Louis-Legere/PixelFarmingContest/README.md

# PixelFarmingContest
This is the repository for the pixel farming robot contest. <br>
[Motor Setup guide](Docs/markdownFiles/motorSetupGuide.md)
