Louis-Legere/PixelFarmingContest/Robot Competition Docs/Handover/OneDrive_1_9.9.2024/Reports/Plan of action.docx

# Agrobot competition

Plan of Action

Fontys Venlo

06-10-2023

By Boris Bonchev, Tom Jacobs, Nils Kronig, Duarte Somsen, and Liz van Tienoven.

Contents

# Version control

Version | Purpose/Change | Date
0.1 | Initial draft | 06/10/2023

# 1. Requirements

## 1.1 Fixed requirements

- The Agrobot must not exceed the given dimensions [1].
- The Agrobot must not weigh more than 100kg.
- The Agrobot must be able to move over all the planters and collection bins.
- The Agrobot must be able to pick up individual crops.
- The Agrobot must use image recognition software to recognize the type of crop and its location in the pixel.
- Crops shall be sorted into their appropriate bin.
- Harvesting and sorting shall not take longer than 15 minutes.
- The purchasing budget must not exceed €3.000, -.

## 1.2 Variable requirements

- The Agrobot is modular so it can be transported easily.
- The motors for the tires are strong enough to not get stuck in the dirt.
- The Agrobot uses gps with a base station to determine its location on the field.

## 1.3 Wishes

- The Agrobot sorts the crops internally first, before dropping the contents into the bins.
- The amount of money spent should be as low as possible.

Users | Manufactures | Requirements | Fixed | Variable | Wish | Success criteria
| X | The Agrobot must not exceed the given dimensions. | X | | | The Agrobot is smaller than the maximum dimensions.
| X | The Agrobot must not weigh more than 100 kg | X | | | The Agrobot is lighter than 100kg.
| X | The Agrobot must be able to move over all the planters and collection bins. | X | | | The Agrobot has a slot large enough to drive over the planters and collection bins.
| X | The Agrobot must be able to pick up individual crops. | X | | | The Agrobot has a gripper and vision to select and grip a single crop.
| X | The Agrobot must use image recognition software to recognize the type of crop and its location in the pixel. | X | | | The Agrobot has a camera and a vision model trained to detect the location and type of plants.
| X | Crops shall be sorted into their appropriate bin. | X | | | The Agrobot places the harvested crops into the corresponding bin.
| X | Harvesting and sorting shall not take longer than 15 minutes. | X | | | The complete harvesting and sorting are completed within 15 minutes.
| X | The purchasing budget must not exceed €3.000, - | X
| X | The Agrobot is modular so it can be transported easily. | | X | | The robot can be taken apart into large parts to facilitate transportation.
| X | The motors for the tires are strong enough to not get stuck in the dirt. | | X | | The Agrobot does not get stuck in the dirt during operation.
| X | The Agrobot uses gps with a base station to determine its location on the field. | | X | | The Agrobot can navigate through the field based on gps.
| X | The Agrobot sorts the crops internally first, before dropping the contents in the bins. | | | X | The Agrobot collects multiple types of crops which end up in their corresponding bins.
| X | The amount of money spent should be as low as possible | | | X

# 2. Risk analysis

| | | | Probability of Occurrence
| | | | Rarely | Unlikely | Possible | Likely | Certain
| Operational | Effects | Rate | 1 | 2 | 3 | 4 | 5
Possible consequences | Critical impact. Possible project termination | Catastrophic | 5 | 5 | 10 | 15 | 20 | 25
| Major/ significant impact. Severe disruption to the project | Major | 4 | 4 | 8 | 12 | 16 | 20
| Moderate impact. Moderate disruption to the project | Moderate | 3 | 3 | 6 | 9 | 12 | 15
| Localized impact. Disruption to the project. | Minor | 2 | 2 | 4 | 6 | 8 | 10
| Minimal or no impact. Minimal disruption. | Insignificant | 1 | 1 | 2 | 3 | 4 | 5

Legend
RPN | Risk priority number
NP | New probability
NI | New Impact
NRPN | New Risk Priority Number

Cause | Risk | Effect | Probability | Impact | RPN | Measure to be limited | Action holder | NW | NI | NRPN
Parts don’t get delivered on time | | | | | | Don’t order from AliExpress
Scope to big | Lack of Time | Project delayed/ unfinished | 5 | 4 | 20 | Try to limit Scope by taking as many compromises as possible | All team Members | 3 | 3 | 9
Physical/ Mechanical failure later in Project | Lack of Time | Project delayed/ unfinished | 2 | 4 | 8 | Order quality parts from trusted vendors. | All team members | 1 | 4 | 4
Miscommunication within the team | Stagnation of the project | Project delayed | 3 | 4 | 12 | Spend more time on diagrams, documents and other communication. | All team members | 2 | 3 | 6
Not able to work in the workshop | Stagnation of project | Project delayed | 4 | 4 | 16 | Reserve the workshop for some time each week. | All team members | 2 | 4 | 8

# 3. Planning

What? | By whom? | When?
Plan of action | Whole team | Week 40
Set up ROS | Boris, Duarte, Tom | Week 41
Set up ROS simulation environment | Tom | Week 41
Vacation | | Week 42
Gripper design | Liz, Nils | Week 42
Pathfinding in simulation | Tom | Week 44
Gripper translation in simulation | Boris | Week 44
Robot Base design | Liz, Nils | Week 44
AI plant recognition | Duarte | Week 45
Gripper | Liz, Nils | Week 45
Agrobot mechanical part complete | Liz, Nils | Week 46
Gripper software | Boris | Week 47
GPS location | Tom | Week 47
Pathfinding on robot | Tom | Week 49
Crop sorting and delivery | Duarte, Boris (help)
Electrics complete | Liz, Nils | Week 1
Vacation | | Week 52 / 1
Agrobot complete | Whole team | Week 2
Agrobot testing | Whole team | Week 3
COMPETITION!!! | Whole team | Week 4

Week (CW) | 40 | 41 | 42 | 43 | 44 | 45 | 46 | 47 | 48 | 49 | 50 | 51 | 52 | 1 | 2 | 3 | 4
Plan of action | 06. 10.
writing
Mechanical work | | | | | | | | | | | | | | | | | 25. 01.
Robot Base design
Robot Base Build
Robot Base Improvement
Gripper design
Gripper Build
Electrics of the Base
Electrics of the Gripper
Software work | | | | | | | | | 01. 12.
Object detection
Path planning of robot
Software of Robot arm

# Appendix

## Appendix 1: Permitted dimensions

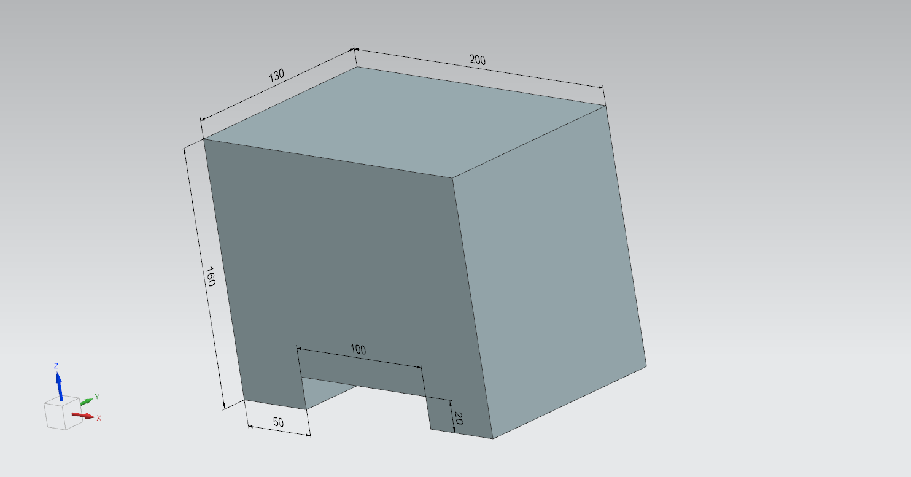
[picture p6: figure]
