Louis-Legere/PixelFarmingContest/Robot Competition Docs/Handover/OneDrive_1_9.9.2024/Reports/Report writings Design and Hardware.docx

Mechanical design

- Constraints for the design
- Previous ideas/designs
- Why this design for the frame?
- Design for the sorting boxes
- Gripper

Hardware

- Why the aluminium profiles?
- Explanation for electronics(?)
- Wheels

While designing the robot, certain constraints had to be taken into consideration.

- The maximum dimensions of the robot are 200x130x160 (WxLxH) cm
- The maximum weight of the robot is 100 kg.
- It has to be able to drive over or around the planter box that is 100x100x20 cm
- It has to be able to harvest the crops that are planted in the planter box.
- The robot has to be able to bring the crops to sorting boxes.

With these constraints in mind, a few designs can be made.

For stability during harvesting, the robot will drive over the planter box. So the robot has to be at least around 120cm wide on the inside, so there is some space left for the wheels and it can easily drive over the planter box. The robot will have internal sorting boxes, so it won’t have to drive to the regular sorting boxes every time it harvests a crop. And it needs an arm that will harvest the crops.

The sorting boxes on the robot had to be designed in such a way that the crops inside could be transferred to the outside sorting boxes fast and easy. Letting the robot arm take each crop and put it in the correct box would take too much time. The solution is to have the bottom of the internal boxes drop open so that the crops just fall into the sorting boxes. The bottom flaps will be connected to the main body of the box with hinges. To get the flaps to open and close again, a stepper motor is used. A disc will be connected to the stepper motor and that disc will roll up a cable that is connected to the flaps. Then by making the stepper motor turn clockwise and anticlockwise, the flaps will open and close.

INSERT PICTURE OF CAD MODELS OF FLAP AND FOLDED BOX

For the gripper, multiple options were considered. Suction using a vacuum cup, gripping the leaves/root from the top and pulling, gripping the leaves/root from the side and pulling. Because of the leaves, vacuum suction is not the best idea because it can never close off completely. Gripping the leaves from the top would be difficult, because they can be very widespread, or the gripper is only able to grab a few leaves and then it will pull with too much force and the leaves rip. Grabbing the root from the top might damage the vegetable and if there are a lot of leaves on top of the root, grabbing the root is not even possible. So the best option is to grab the crop from the side, the best point being the area where the root grows its leaves.

To build the frame, aluminium profiles are used because aluminium has a higher strength-to-weight ratio than wood (https://windowfactory.co.nz/advantages-of-aluminium-framing-over-wood/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,against%20forced%20entry%20than%20timber.). The wheels are connected to the lowest left and right profile with a steel bracket. To make sure that those profiles can endure the forces of the wheels, they are so-called double profiles. The rest of the robot doesn’t have to endure so much force, so singular profiles are sufficient there. To make a frame with the profiles, multiple types of connecting hardware are used. INSERT ZOOMED-IN PICTURES OF ALL CONNECTIONS AND BRIEFLY EXPLAIN THEM

The wheels used on the robot are two electric and two swivel wheels. The electric wheels both have an 8-inch 48V DC Brushless HUB motor, that is powered by an Odrive. The wheels will pull the robot forward in a straight line when the wheels turn at the same speed. When the robot needs to make a turn, the wheels will turn at different speeds and the robot will turn around the wheel that is turning the slowest. The swivel wheels at the back are mostly for stability. They will stay straight when the robot is driving in a straight line, and they will ease the turning when the robot is making a turn.
