Louis-Legere/PixelFarmingContest/Robot Competition Docs/3_Axis_System_Speed_and_Pulley_Diameter_Calculation.docx

# Speed and Pulley Diameter Calculation for a 3-Axis System

To determine the appropriate speed and pulley diameter for the 3-axis system using a T5 belt (5 mm pitch, 10 mm width), we proceed as follows:

Diameter = (Number of Teeth x Pitch) / π

For a 16-tooth pulley:

Diameter = (16 x 5 mm) / π ≈ 25.46 mm

### Calculation of Linear Speed:

1. Stepper Motor Speed: NEMA 23 stepper motors can typically reach up to 1000 RPM, but for reliability and accuracy, we should assume a more conservative value, around 250 RPM.

2. Revolutions per Second (RPS):
RPS = (250 RPM) / (60 seconds) ≈ 4,17 RPS

3. Linear Speed:
The linear speed (v) can be calculated with the circumference of the pulley and the rotational speed:
v = RPS x Circumference

The circumference (U) of the pulley:
U = π x Diameter = π x 25.46 mm ≈ 80 mm

Thus:
v = 4.17 RPS x 80 mm ≈ 333 mm/s

## Summary

- Pulley Diameter: A 16-tooth pulley for a T5 belt has a diameter of approximately 25.46 mm.
- Linear Speed: At a speed of 250 RPM, the system can achieve a linear speed of approximately 333 mm/s.
