Louis-Legere/PixelFarmingContest/Robot Competition Docs/introduction gantry system.docx

The dimensions of the gantry system it self are 1261 x 1114 x 715 mm, wich fits perfectly in our frame with the inner dimensions of 1200 x 1170 x 360 mm. The gantry system does not simply rest on the frame but is supported at the end with the bins by a transverse 30x 30 mm aluminum profile and allows the z axle including gripper to drive over the edge of the bins. at the other end or at the front, the gantry system rests on two 30x 30x 30 mm aluminum profiles. In addition, two aluminum profiles support the drive axle on the x axle. To connect the profiles, we use special brackets with screws which tighten with embedded pieces in the profiles. Based on this, most of the screws are not shown in the pictures as this would be over 300 parts and thus increase the working memory size of the file, which is inferior.
