Louis-Legere/PixelFarmingContest/Robot Competition Docs/Handover/OneDrive_1_9.9.2024/Powerpoint-sjablonen-mei-2023/Powerpoint-sjablonen-mei-2023/Algemene_Presentatie_Fontys_NL.pptx

## TITELBLAD VAN DE POWERPOINT

## TITELBLAD VAN DE POWERPOINT

## Slide 4

## Slide 5

## Slide 6

## Slide 7

## Slide 8

## Slide 9

## Slide 10

## Slide 11
