Louis-Legere/PixelFarmingContest/Docs/Datasheets/stateTransitions.png

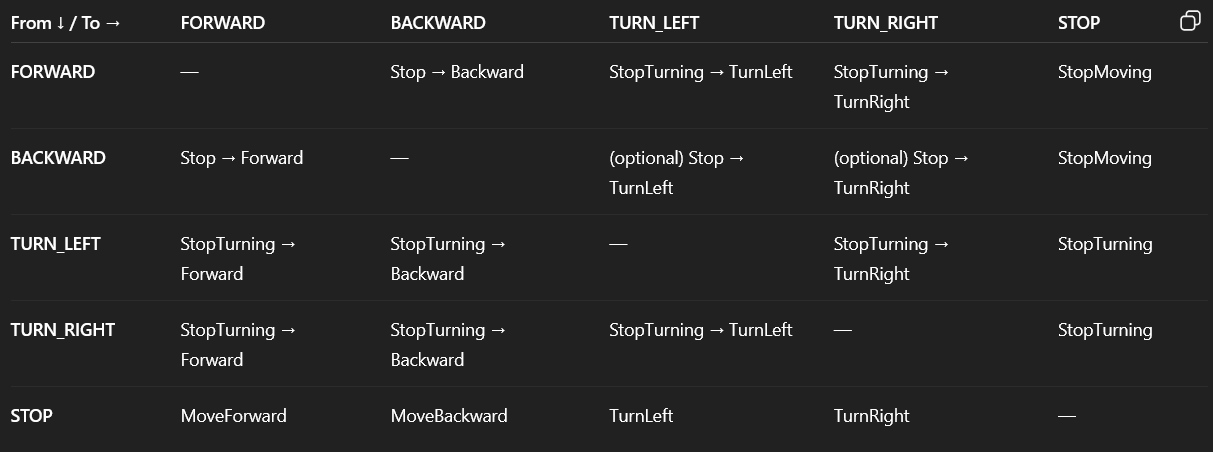
Docs/Datasheets/stateTransitions.png
