Louis-Legere/PixelFarmingContest/Docs/purpleHexagon.jpg

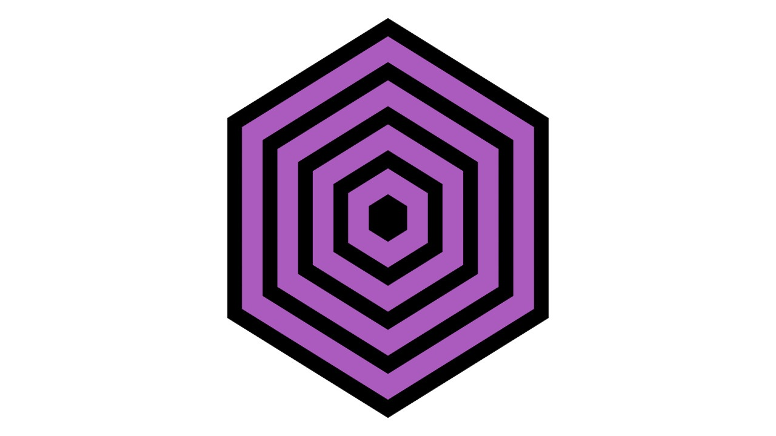
Docs/purpleHexagon.jpg
