Louis-Legere/PixelFarmingContest/Robot Competition Docs/Handover/OneDrive_1_9.9.2024/All work file/Agrobot_ws-main/Agrobot_ws-main/Design artifacts/ArmControllerCommandSheet.jpeg

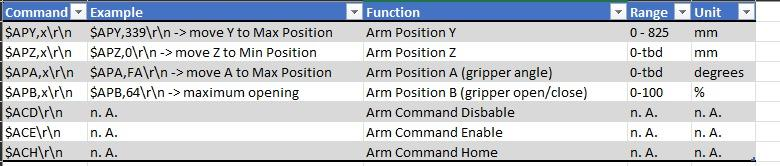
Robot Competition Docs/Handover/OneDrive_1_9.9.2024/All work file/Agrobot_ws-main/Agrobot_ws-main/Design artifacts/ArmControllerCommandSheet.jpeg
