Louis-Legere/PixelFarmingContest/Robot Competition Docs/Handover/OneDrive_1_9.9.2024/All work file/Datasheets/our.jpg

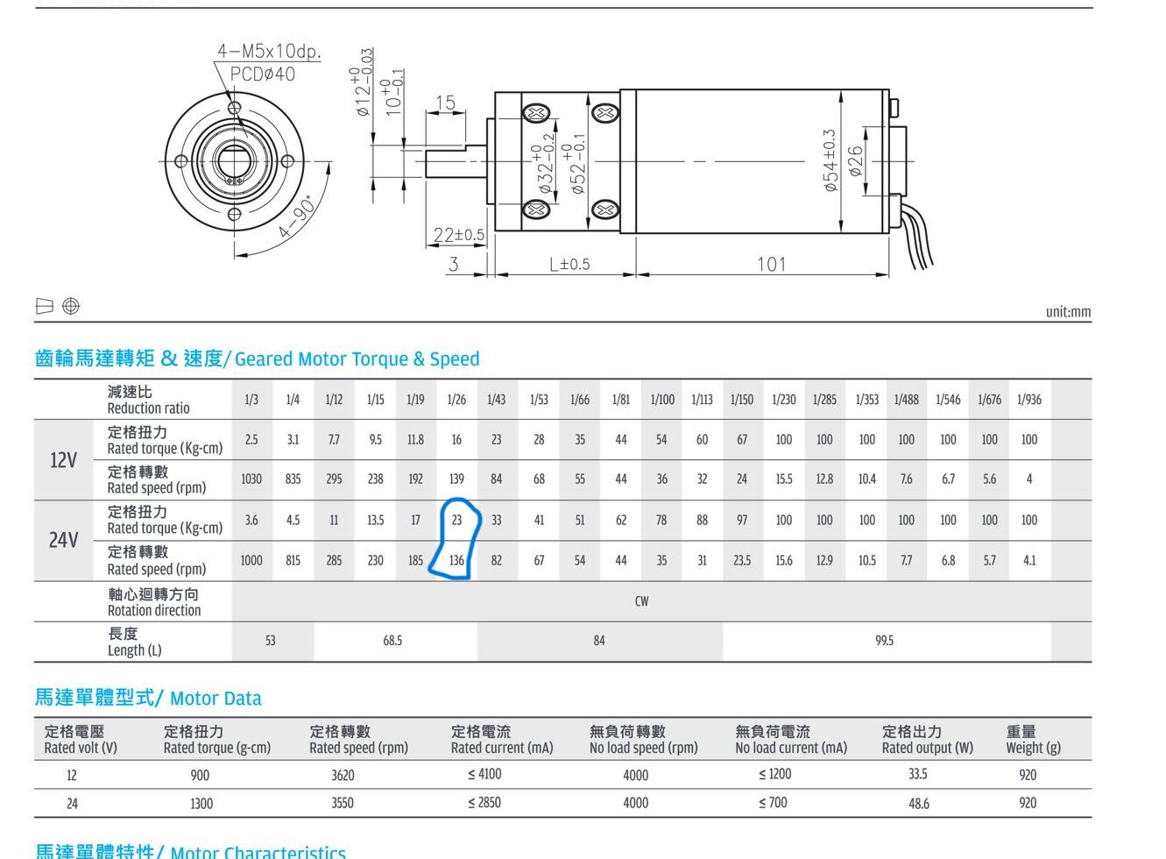
Robot Competition Docs/Handover/OneDrive_1_9.9.2024/All work file/Datasheets/our.jpg
