Louis-Legere/PixelFarmingContest/Robot Competition Docs/Handover/OneDrive_1_9.9.2024/All work file/Datasheets/TD-045-285_4_1920x1920.jpg

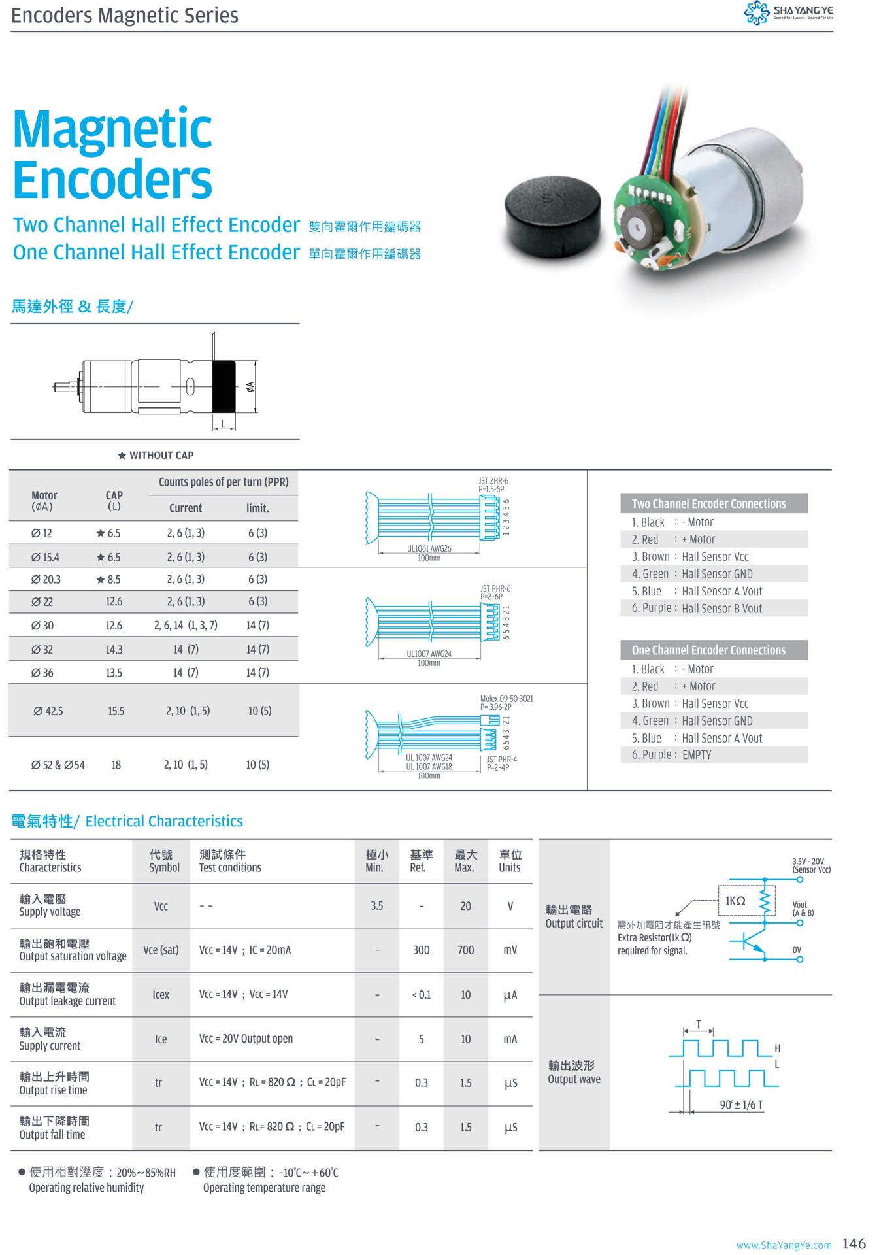
Robot Competition Docs/Handover/OneDrive_1_9.9.2024/All work file/Datasheets/TD-045-285_4_1920x1920.jpg
