Louis-Legere/PixelFarmingContest/Robot Competition Docs/Handover/OneDrive_1_9.9.2024/Research/milestones chart.png

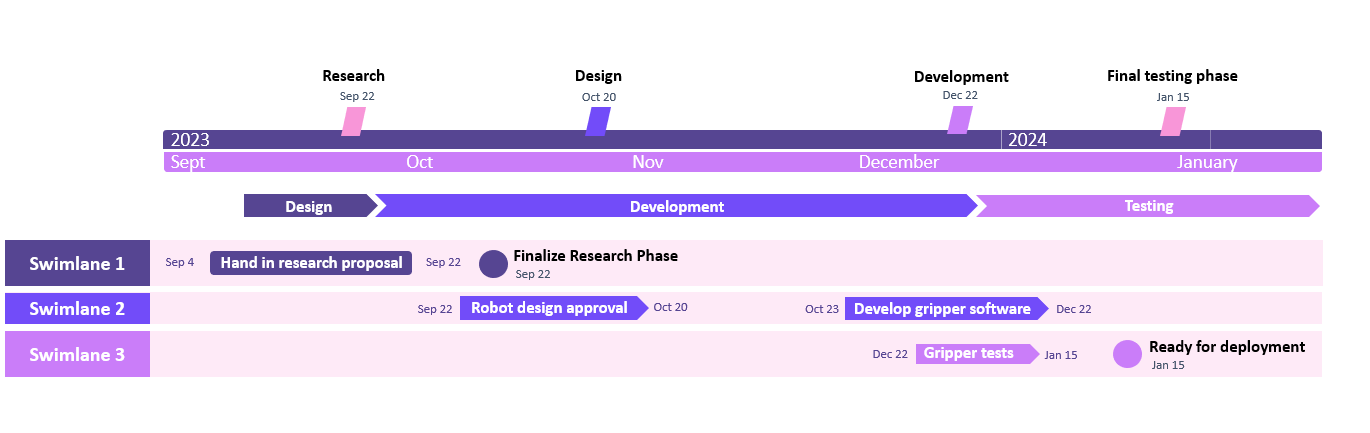
Robot Competition Docs/Handover/OneDrive_1_9.9.2024/Research/milestones chart.png
