Louis-Legere/PixelFarmingContest/Robot Competition Docs/Handover/OneDrive_1_9.9.2024/Research/robot_max_size.png

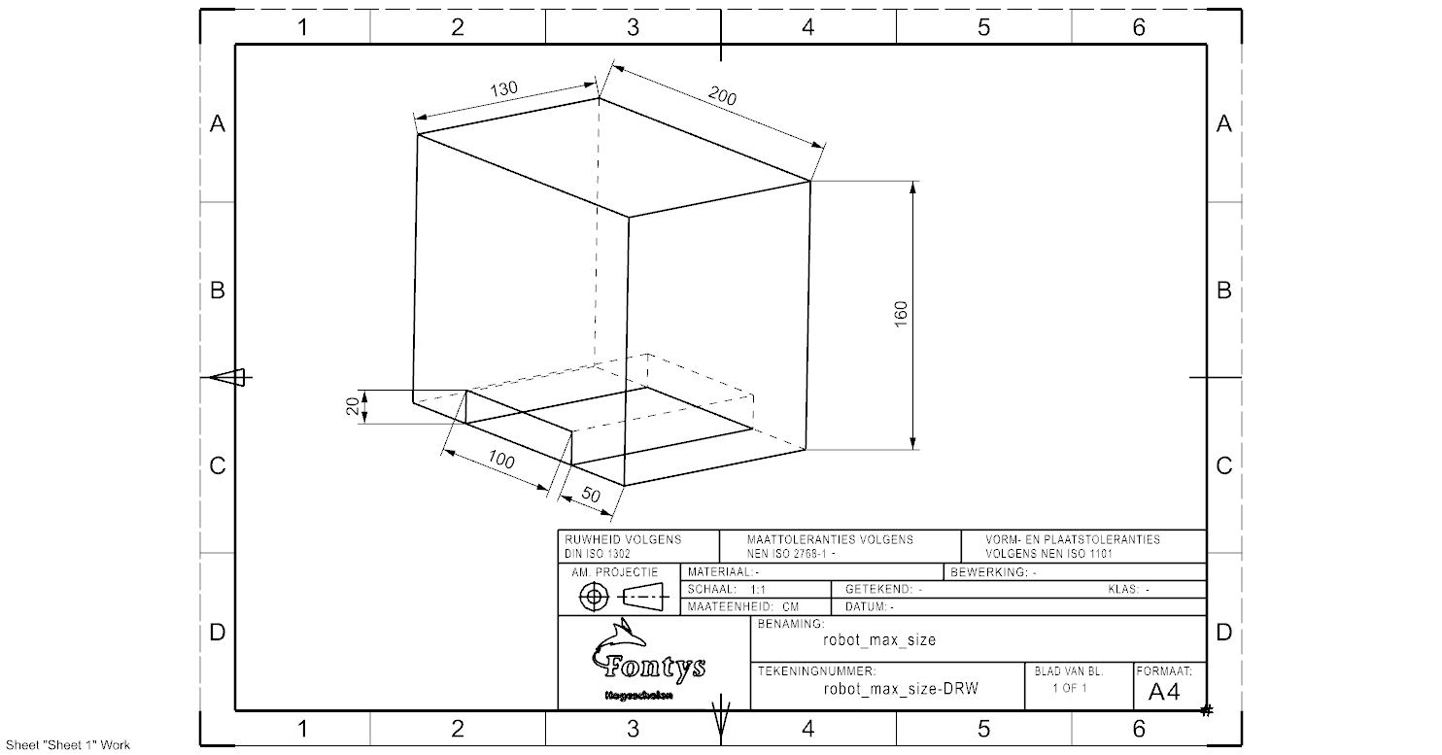
Robot Competition Docs/Handover/OneDrive_1_9.9.2024/Research/robot_max_size.png
