Louis-Legere/PixelFarmingContest/Robot Competition Docs/Handover/OneDrive_1_9.9.2024/Order Form/Bestelformulier Projecten.xlsx

Bestelformulier Projecten
Algemene gegevens
Student* | Liz van Tienoven
Opdrachtgever | Marius Monen
Begeleidend docent * |  | Voor het bestellen moet de docent toestemming hebben gegeven (via mail of in de teams-omgeving).
Projectnaam / module * | Agrobot gantry
Budgetnummer | P049248-101
Projectgroep | Agrobot gantry - Minor Robotisering / MIM / ETP / A-systems
Afleveradres (bij hogeschool) * | Tegelseweg 255, 5912 BG, Venlo
T.a.v. (naam en intern adres medewerker) * | Gennip,Frank
* Deze velden zijn verplicht Onvolledig ingevulde bestellingen worden niet in behandeling genomen
Artikelnummer leverancier* | Artikelnaam / beschrijving* | Aantal* | Stuksprijs* | leverancier* | weblink | Afleveradres tav medewerker bij kennisinstelling
1024235 | ISB blokverbinder set sleuf 8 3D | 4 | €9.44 | Techniek specialist | https://www.tech-specialist.com/nl/type-isb/profielverbinders-isb/rechte-hoekverbinders-isb/blokverbinders-isb/rechte-hoekverbinders-isb-blokverbinder-set-sle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 | Gennip,Frank
1007471 | ISB aluminium profiel sleuf 8 40x80-L, Lengte = 1540 mm | 2 | €58.76 | Techniek specialist | https://www.tech-specialist.com/nl/type-isb/aluminium-profielen-isb/sleuf-8-isb/aluminum-profiel-isb-40x80-l-1007471 | Gennip,Frank
1007470 | ISB aluminium profiel sleuf 8 40x40-L, Lengte = 1200 mm | 6 | €27.84 | Techniek specialist | https://www.tech-specialist.com/nl/type-isb/aluminium-profielen-isb/sleuf-8-isb/aluminum-profiel-isb-40x40-l-1007470 | Gennip,Frank
1007470 | ISB aluminium profiel sleuf 8 40x40-L, Lengte = 700 mm | 4 | €17.59 | Techniek specialist | https://www.tech-specialist.com/nl/type-isb/aluminium-profielen-isb/sleuf-8-isb/aluminum-profiel-isb-40x40-l-1007470 | Gennip,Frank
