Louis-Legere/PixelFarmingContest/Robot Competition Docs/Handover/OneDrive_1_9.9.2024/Order Form/Bestelformulier Aluminium profielen.xlsx

Bestelformulier Projecten
Algemene gegevens
Student* | Liz van Tienoven
Opdrachtgever | Marius Monen
Begeleidend docent * |  | Voor het bestellen moet de docent toestemming hebben gegeven (via mail of in de teams-omgeving).
Projectnaam / module * | Agrobot gantry
Budgetnummer | P049248-101
Projectgroep | Agrobot gantry - Minor Robotisering / MIM / ETP / A-systems
Afleveradres (bij hogeschool) * | Tegelseweg 255, 5912 BG, Venlo
T.a.v. (naam en intern adres medewerker) * | Gennip,Frank
* Deze velden zijn verplicht Onvolledig ingevulde bestellingen worden niet in behandeling genomen
Artikelnummer leverancier* | Artikelnaam / beschrijving* | Aantal* | Stuksprijs* | leverancier* | weblink | Afleveradres tav medewerker bij kennisinstelling
1024235 | ISB blokverbinder set sleuf 8 3D | 4 | €9.44 | Techniek specialist | https://www.tech-specialist.com/nl/type-isb/profielverbinders-isb/rechte-hoekverbinders-isb/blokverbinders-isb/rechte-hoekverbinders-isb-blokverbinder-set-sle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 | Van der Wijst, Gert-Jan
1007471 | ISB aluminium profiel sleuf 8 40x80-L, Lengte = 1540 mm | 2 | €58.76 | Techniek specialist | https://www.tech-specialist.com/nl/type-isb/aluminium-profielen-isb/sleuf-8-isb/aluminum-profiel-isb-40x80-l-1007471 | Van der Wijst, Gert-Jan
1007470 | ISB aluminium profiel sleuf 8 40x40-L, Lengte = 1200 mm | 8 | €27.84 | Techniek specialist | https://www.tech-specialist.com/nl/type-isb/aluminium-profielen-isb/sleuf-8-isb/aluminum-profiel-isb-40x40-l-1007470 | Van der Wijst, Gert-Jan
1007470 | ISB aluminium profiel sleuf 8 40x40-L, Lengte = 700 mm | 4 | €17.59 | Techniek specialist | https://www.tech-specialist.com/nl/type-isb/aluminium-profielen-isb/sleuf-8-isb/aluminum-profiel-isb-40x40-l-1007470 | Van der Wijst, Gert-Jan
1007762 | ISB hoekverbinder sleuf 8 40x80 | 8 | €7.77 | Techniek specialist | https://www.tech-specialist.com/nl/type-isb/profielverbinders-isb/rechte-hoekverbinders-isb/hoekverbinders-isb/rechte-hoekverbinders-isb-hoekverbinder-sleuf-8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 | Van der Wijst, Gert-Jan
1007754 | ISB hoekverbinder sleuf 8 40x40 | 24 | €3.62 | Techniek specialist | https://www.tech-specialist.com/nl/type-isb/profielverbinders-isb/rechte-hoekverbinders-isb/hoekverbinders-isb/rechte-hoekverbinders-isb-hoekverbinder-sleuf-8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 | Van der Wijst, Gert-Jan
1008393 | ISB t-sleuf moer sleuf 8 M8 | 88 | €0.50 | Techniek specialist | https://www.tech-specialist.com/nl/type-isb/bevestigingsmaterialen-isb/t-sleuf-moeren-isb/t-sleuf-moer-isb/t-sleuf-moeren-isb-sleuf-moer-sleuf-8-m8-1008393 | Van der Wijst, Gert-Jan
1008240 | TEC bolkop inbusbout ISO 7380-1 M8x16 | 88 | €0.67 | Techniek specialist | https://www.tech-specialist.com/nl/type-isb/bevestigingsmaterialen-isb/bouten-isb/bolkop-inbusbouten-isb/bolkop-inbusbouten-tec-bolkop-inbusbout-iso-7380-1-m8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 | Van der Wijst, Gert-Jan
1008388 | ISB t-sleuf moer sleuf 5 M5 | 8 | €0.63 | Techniek specialist | https://www.tech-specialist.com/nl/type-isb/bevestigingsmaterialen-isb/t-sleuf-moeren-isb/t-sleuf-moer-isb/t-sleuf-moeren-isb-t-sleuf-moer-sleuf-5-m5-1008388 | Van der Wijst, Gert-Jan
1008232 | TEC bolkop inbusbout ISO 7380-1 M5x8 | 8 | €0.46 | Techniek specialist | https://www.tech-specialist.com/nl/type-isb/bevestigingsmaterialen-isb/bouten-isb/bolkop-inbusbouten-isb/bolkop-inbusbouten-tec-bolkop-inbusbout-iso-7380-1-m5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 | Van der Wijst, Gert-Jan
 |  |  | €709.08
