Louis-Legere/PixelFarmingContest/Robot Competition Docs/Assem1/Assem1.SLDASM

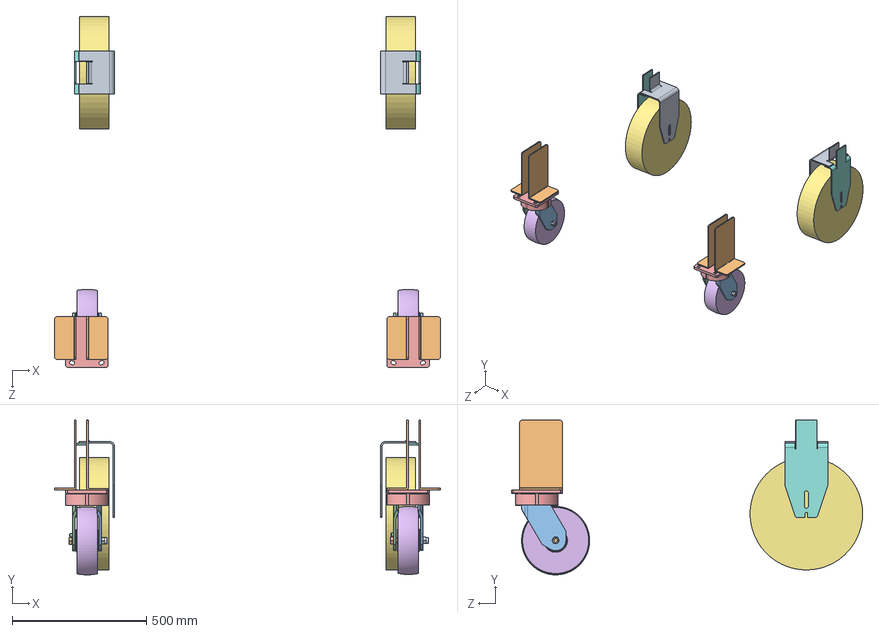
[picture p42: CAD file, 2025-09-10]
Robot Competition Docs/Assem1/Assem1.SLDASM
1440.0 x 577.5 x 1310.5 mm
front wheel angel x 4
rear wheel part 1 x 2
rear wheel part 2 x 2
backwheel x 2
83d123x0sz8600_01 x 2
83d123x0sz8600_02 x 2
83d123x0sz8600_03 x 2
83d123x0sz8600_04 x 2
83d123x0sz8600_05 x 2
83d123x0sz8600_06 x 2
