Louis-Legere/PixelFarmingContest/Robot Competition Docs/assembly final updated/Assem1.SLDASM

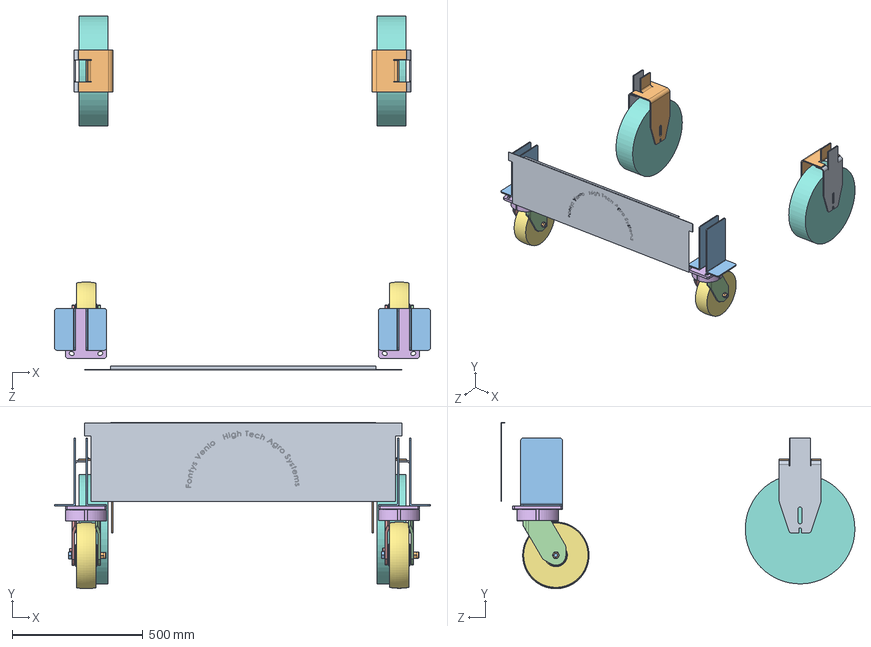
[picture p43: CAD file, 2025-09-10]
Robot Competition Docs/assembly final updated/Assem1.SLDASM
1440.0 x 637.4 x 1355.1 mm
front wheel angel x 4
rear wheel part 1 x 2
rear wheel part 2 x 2
backwheel x 2
83d123x0sz8600_01 x 2
83d123x0sz8600_02 x 2
83d123x0sz8600_03 x 2
83d123x0sz8600_04 x 2
83d123x0sz8600_05 x 2
83d123x0sz8600_06 x 2
door v2
