Louis-Legere/PixelFarmingContest/Robot Competition Docs/assembly final/bin.SLDASM

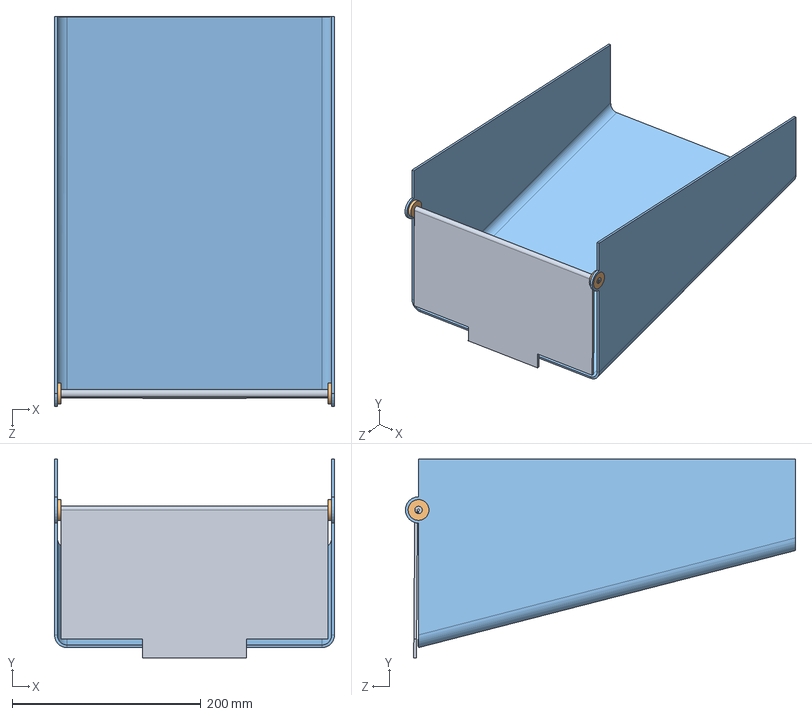
[picture p44: CAD file, 2025-09-10]
Robot Competition Docs/assembly final/bin.SLDASM
297.0 x 211.0 x 414.0 mm
bin base
ball bearing place holder x 2
door
