Louis-Legere/PixelFarmingContest/Robot Competition Docs/assembly final/83d123x0sz8600.SLDASM

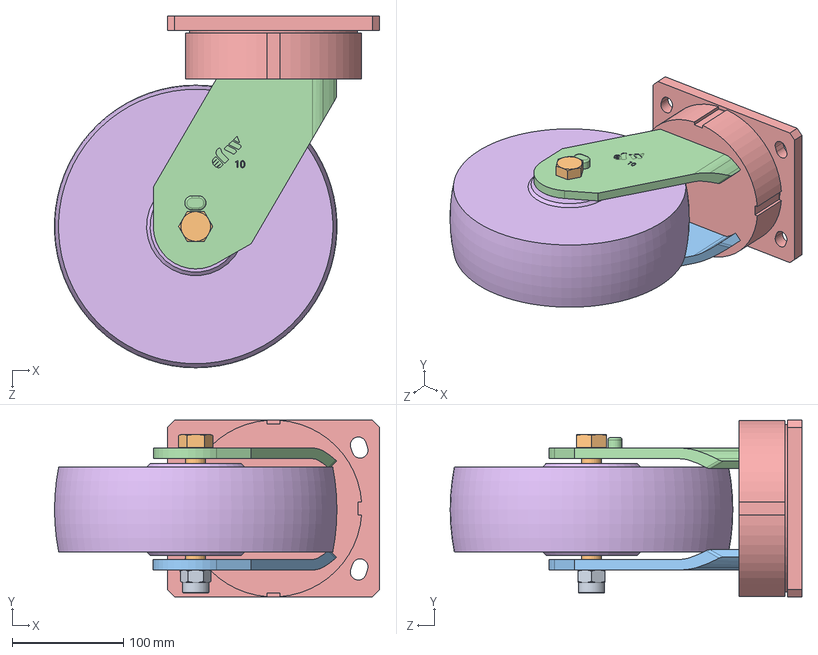
[picture p45: CAD file, 2025-09-10]
Robot Competition Docs/assembly final/83d123x0sz8600.SLDASM
292.0 x 158.8 x 316.0 mm
83d123x0sz8600_01
83d123x0sz8600_02
83d123x0sz8600_03
83d123x0sz8600_04
83d123x0sz8600_05
83d123x0sz8600_06
