Louis-Legere/PixelFarmingContest/Robot Competition Docs/door v2 1.sldprt

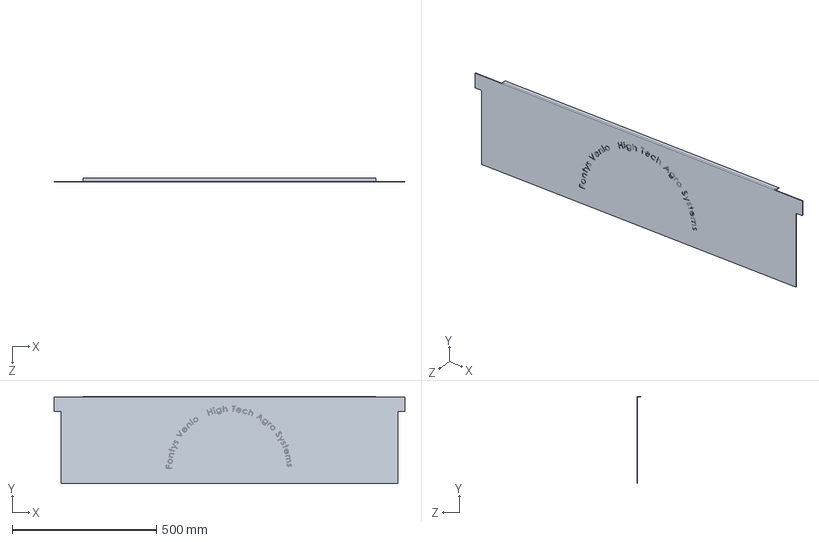
[picture p46: CAD file, 2025-09-10]
Robot Competition Docs/door v2 1.sldprt
1217.0 x 302.7 x 15.0 mm
