Louis-Legere/PixelFarmingContest/Robot Competition Docs/Handover/OneDrive_1_9.9.2024/All work file/Agrobot_ws-main/Agrobot_ws-main/ros2_ws/src/agrobot_pkg/resource/carrot_model.obj

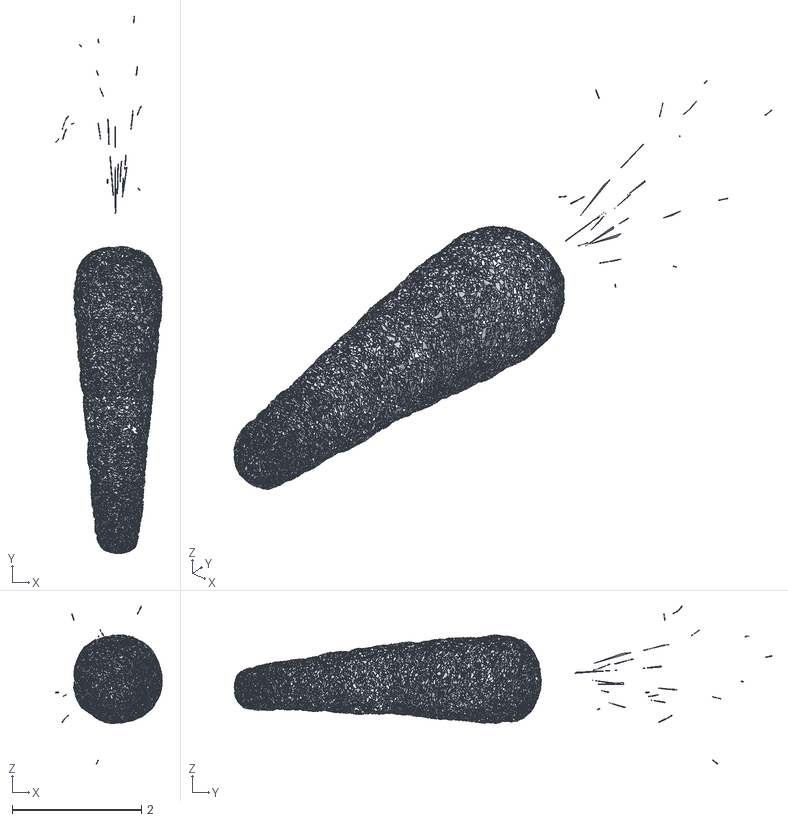
[picture p48: CAD file, 2025-09-10]
Robot Competition Docs/Handover/OneDrive_1_9.9.2024/All work file/Agrobot_ws-main/Agrobot_ws-main/ros2_ws/src/agrobot_pkg/resource/carrot_model.obj
1.65 x 8.32 x 2.45
