Louis-Legere/PixelFarmingContest/Robot Competition Docs/Handover/OneDrive_1_9.9.2024/All work file/Agrobot_ws-main/Agrobot_ws-main/ros2_ws/src/agrobot_pkg/worlds/obj/Base_Scaled_Bigger.stl

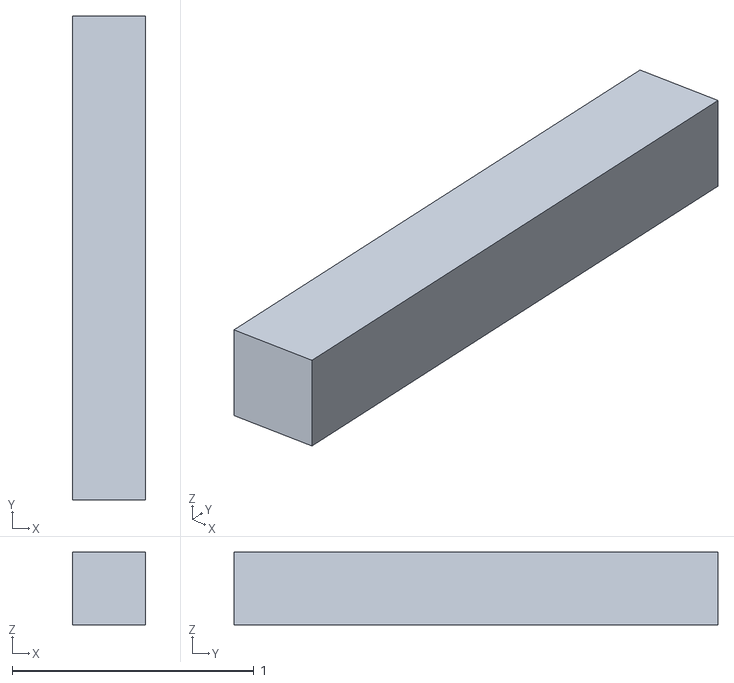
[picture p49: CAD file, 2025-09-10]
Robot Competition Docs/Handover/OneDrive_1_9.9.2024/All work file/Agrobot_ws-main/Agrobot_ws-main/ros2_ws/src/agrobot_pkg/worlds/obj/Base_Scaled_Bigger.stl
0.3 x 2.00 x 0.3
