Louis-Legere/PixelFarmingContest/Robot Competition Docs/Handover/OneDrive_1_9.9.2024/All work file/Bracket endstop v1.step

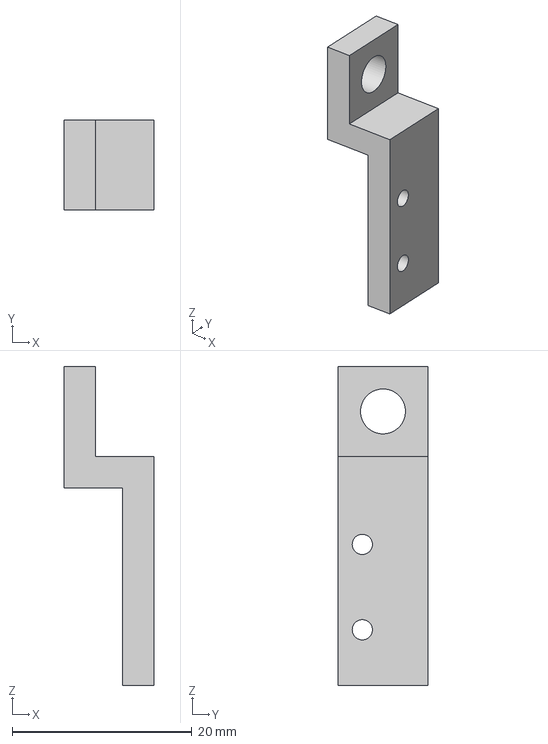
[picture p50: CAD file, 2025-09-10]
Robot Competition Docs/Handover/OneDrive_1_9.9.2024/All work file/Bracket endstop v1.step
10.0 x 10.0 x 35.5 mm
