Louis-Legere/PixelFarmingContest/Robot Competition Docs/Handover/OneDrive_1_9.9.2024/All work file/Frame/Frame/Y-Axes v11.step

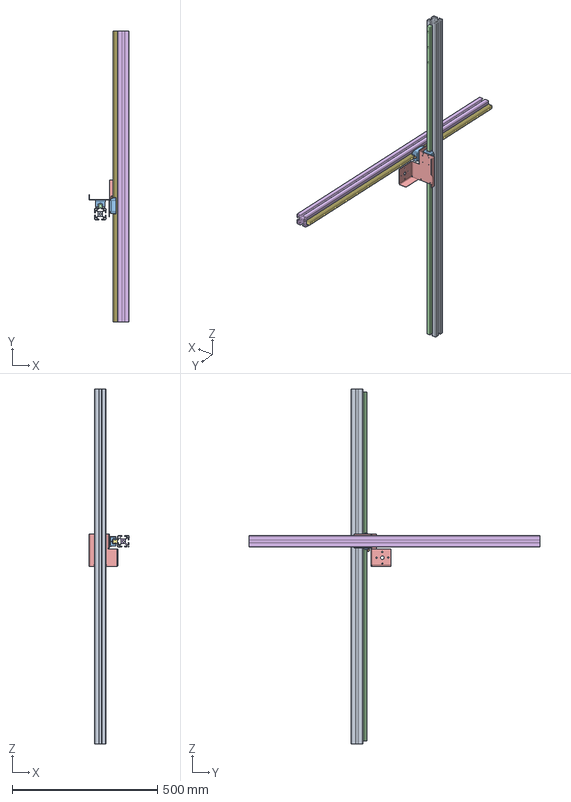
[picture p51: CAD file, 2025-09-10]
Robot Competition Docs/Handover/OneDrive_1_9.9.2024/All work file/Frame/Frame/Y-Axes v11.step
138.7 x 1000.0 x 1222.0 mm
6575N203_T-Slotted Framing Rail
6709K12_Ball Bearing Carriage
6709K301_15 mm Wide x 160 mm Long Guide Rail for Ball Bearing Carriag e
Y-Z Bracket
6575N203_T-Slotted Framing Rail_1
6709K332_15 mm Wide x 1600 mm Long Guide Rail for Ball Bearing Carria ge
6709K12_Ball Bearing Carriage_1
