Louis-Legere/PixelFarmingContest/Robot Competition Docs/Handover/OneDrive_1_9.9.2024/All work file/Sorting box/Sorting box/Box1 v13.step

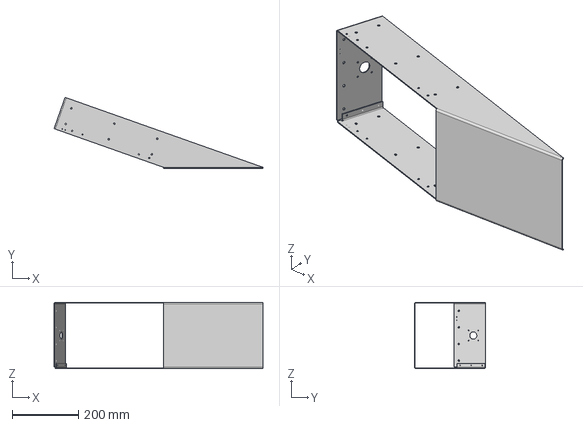
[picture p52: CAD file, 2025-09-10]
Robot Competition Docs/Handover/OneDrive_1_9.9.2024/All work file/Sorting box/Sorting box/Box1 v13.step
630.0 x 214.9 x 199.0 mm
