Louis-Legere/PixelFarmingContest/Robot Competition Docs/Assem1/backwheel.SLDPRT

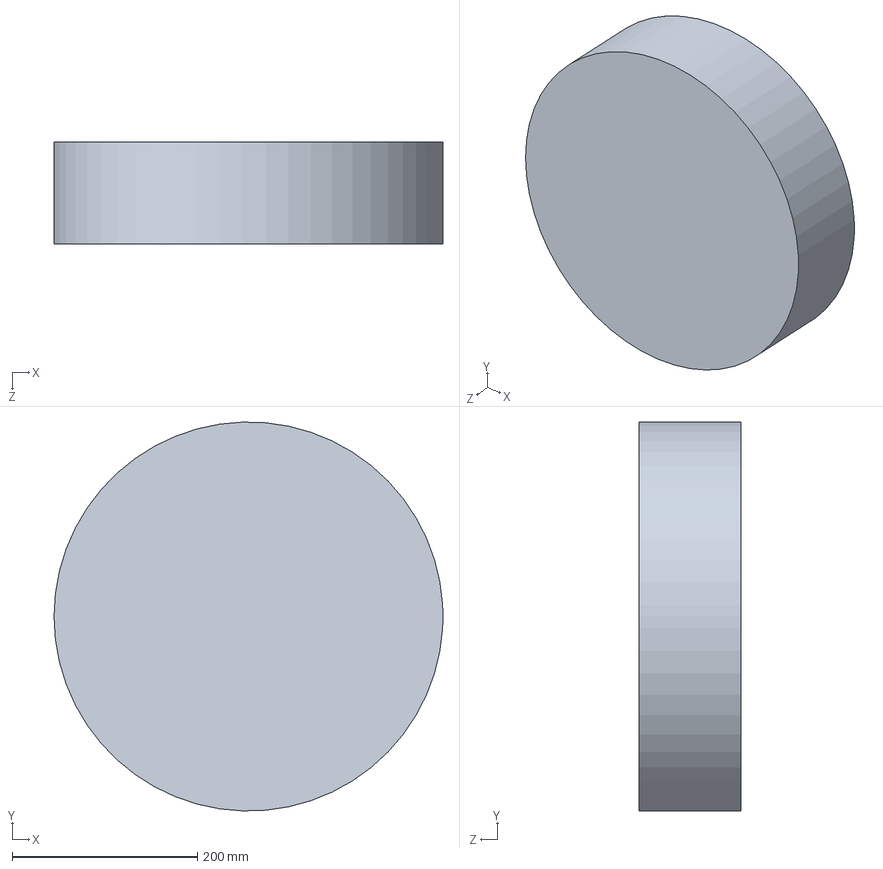
[picture p53: CAD file, 2025-09-10]
Robot Competition Docs/Assem1/backwheel.SLDPRT
420.0 x 419.8 x 110.0 mm
