Louis-Legere/PixelFarmingContest/Robot Competition Docs/assembly final/bins/door.SLDPRT

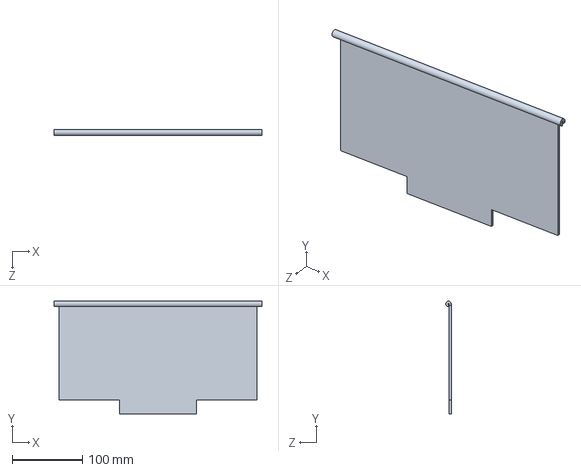
[picture p54: CAD file, 2025-09-10]
Robot Competition Docs/assembly final/bins/door.SLDPRT
297.0 x 161.0 x 8.00 mm
