Louis-Legere/PixelFarmingContest/Robot Competition Docs/Handover/OneDrive_1_9.9.2024/All work file/Aandrijfvoet/Aandrijfvoet/Aandrijfvoet 003_2.0 v1.step

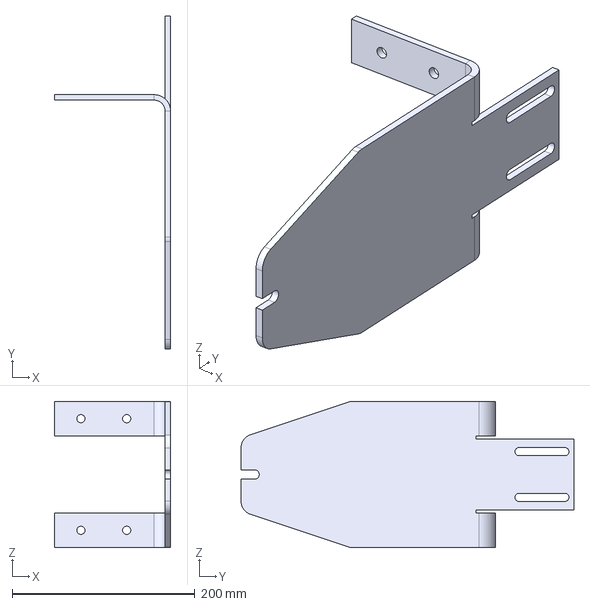
[picture p55: CAD file, 2025-09-10]
Robot Competition Docs/Handover/OneDrive_1_9.9.2024/All work file/Aandrijfvoet/Aandrijfvoet/Aandrijfvoet 003_2.0 v1.step
127.0 x 364.0 x 160.0 mm
