Louis-Legere/PixelFarmingContest/Robot Competition Docs/Handover/OneDrive_1_9.9.2024/All work file/Agrobot_ws-main/Agrobot_ws-main/ros2_ws/src/agrobot_pkg/worlds/obj/Arm_Scaled_Bigger_1.stl

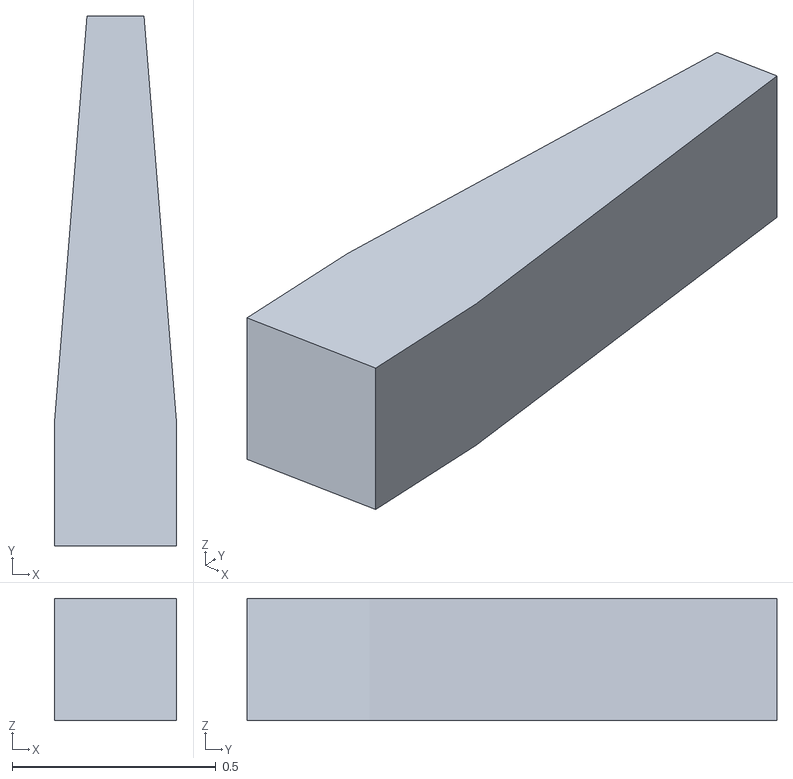
[picture p56: CAD file, 2025-09-10]
Robot Competition Docs/Handover/OneDrive_1_9.9.2024/All work file/Agrobot_ws-main/Agrobot_ws-main/ros2_ws/src/agrobot_pkg/worlds/obj/Arm_Scaled_Bigger_1.stl
0.3 x 1.30 x 0.3
