Louis-Legere/PixelFarmingContest/Robot Competition Docs/Handover/OneDrive_1_9.9.2024/All work file/Frame/Frame/Agrobot Frame v15.step

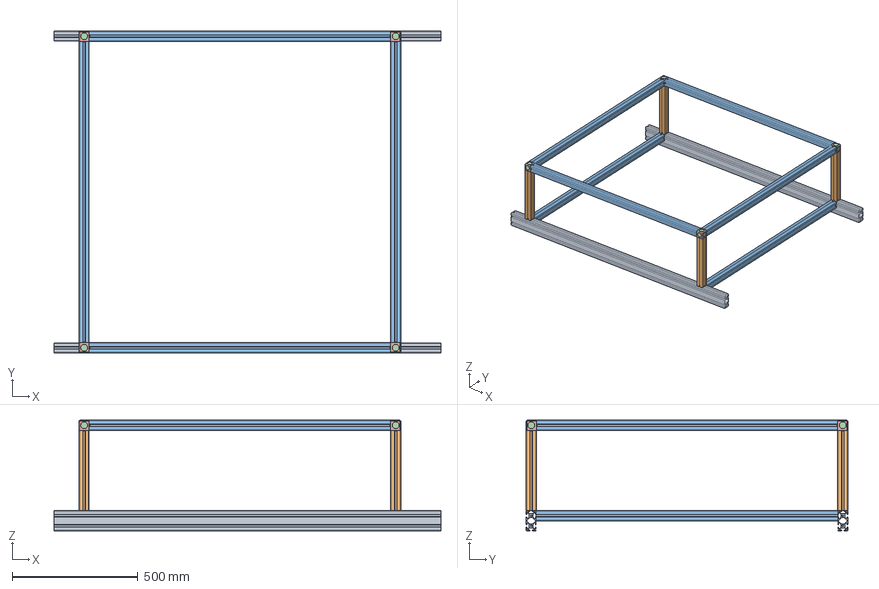
[picture p57: CAD file, 2025-09-10]
Robot Competition Docs/Handover/OneDrive_1_9.9.2024/All work file/Frame/Frame/Agrobot Frame v15.step
1540.0 x 1280.1 x 440.2 mm
3136N737_T-Slotted Framing
3136N737_T-Slotted Framing (1)
6575N183_T-Slotted Framing Rail
6575N183_T-Slotted Framing Rail (1)
6575N183_T-Slotted Framing Rail (2)
6575N183_T-Slotted Framing Rail (3)
6575N204_T-Slotted Framing Rail
6575N204_T-Slotted Framing Rail (1)
6575N204_T-Slotted Framing Rail (2)
6575N204_T-Slotted Framing Rail (1) (1)
5537T291_T-Slotted Framing
6575N204_T-Slotted Framing Rail (1) (1) (1)
6575N204_T-Slotted Framing Rail (1) (1) (1) (1)
5537T291_T-Slotted Framing (1)
5537T291_T-Slotted Framing (2)
5537T291_T-Slotted Framing (3)
