Louis-Legere/PixelFarmingContest/Robot Competition Docs/Handover/OneDrive_1_9.9.2024/All work file/Sorting box/Sorting box/Floor v8.step

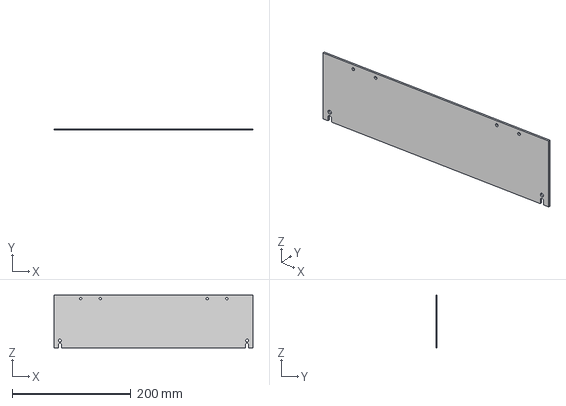
[picture p58: CAD file, 2025-09-10]
Robot Competition Docs/Handover/OneDrive_1_9.9.2024/All work file/Sorting box/Sorting box/Floor v8.step
335.0 x 2.50 x 89.0 mm
