Louis-Legere/PixelFarmingContest/Robot Competition Docs/assembly final/bins/bin base.SLDPRT

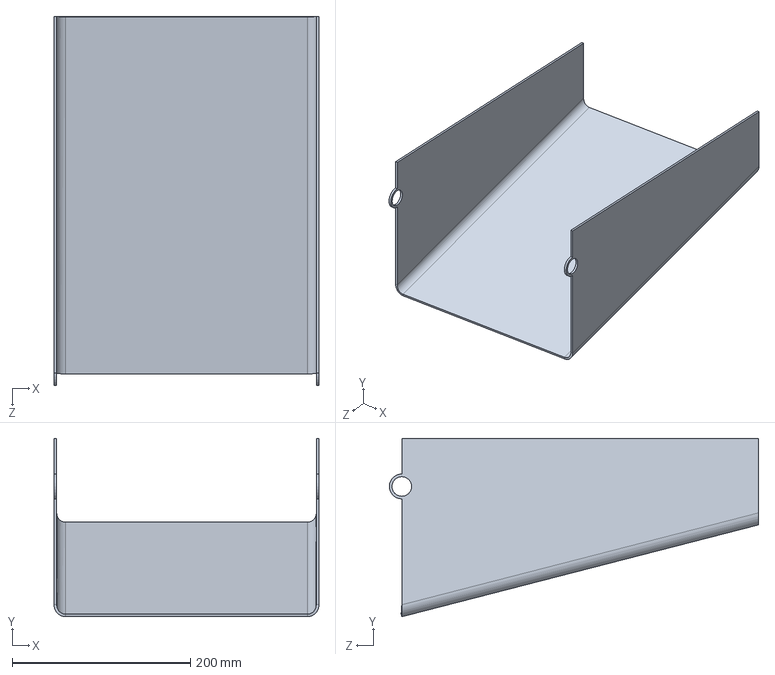
[picture p59: CAD file, 2025-09-10]
Robot Competition Docs/assembly final/bins/bin base.SLDPRT
297.0 x 200.0 x 414.0 mm
