Louis-Legere/PixelFarmingContest/Robot Competition Docs/Handover/OneDrive_1_9.9.2024/All work file/Agrobot_ws-main/Agrobot_ws-main/ros2_ws/src/agrobot_pkg/worlds/obj/Finger_Scaled_Bigger_1.stl

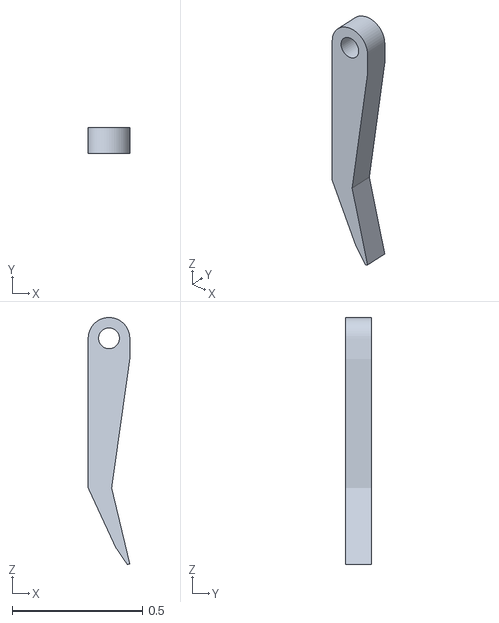
[picture p60: CAD file, 2025-09-10]
Robot Competition Docs/Handover/OneDrive_1_9.9.2024/All work file/Agrobot_ws-main/Agrobot_ws-main/ros2_ws/src/agrobot_pkg/worlds/obj/Finger_Scaled_Bigger_1.stl
0.16 x 0.1 x 0.949
