Louis-Legere/PixelFarmingContest/Robot Competition Docs/Handover/OneDrive_1_9.9.2024/All work file/Sorting box/Sorting box/Spool v2.step

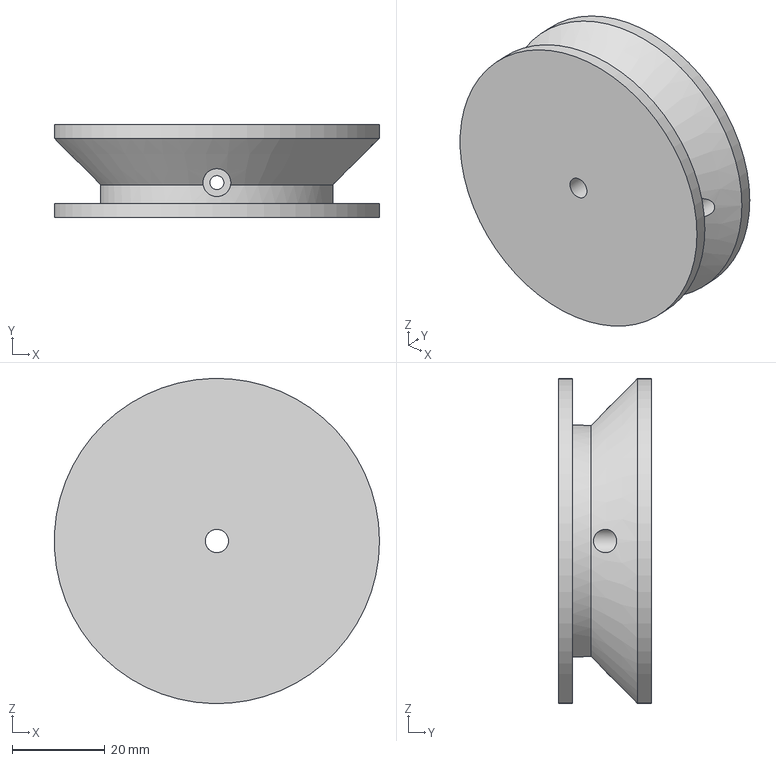
[picture p61: CAD file, 2025-09-10]
Robot Competition Docs/Handover/OneDrive_1_9.9.2024/All work file/Sorting box/Sorting box/Spool v2.step
70.0 x 20.0 x 70.0 mm
