Louis-Legere/PixelFarmingContest/Robot Competition Docs/assembly final/bins/ball bearing place holder.SLDPRT

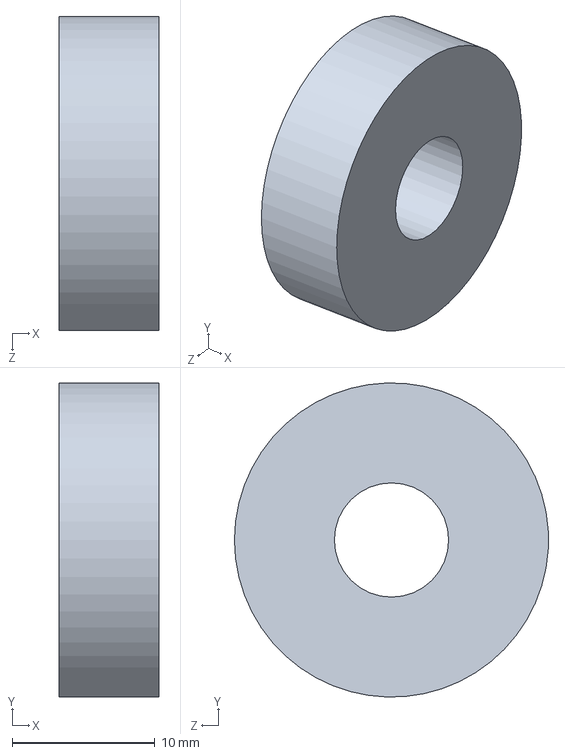
[picture p62: CAD file, 2025-09-10]
Robot Competition Docs/assembly final/bins/ball bearing place holder.SLDPRT
7.00 x 22.0 x 22.0 mm
