Louis-Legere/PixelFarmingContest/Robot Competition Docs/assembly final/rear wheel part 2.SLDPRT

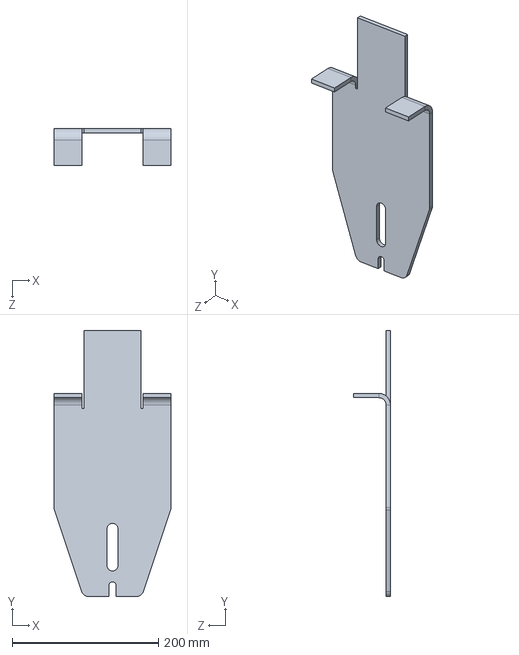
[picture p63: CAD file, 2025-09-10]
Robot Competition Docs/assembly final/rear wheel part 2.SLDPRT
160.0 x 364.0 x 50.7 mm
