Louis-Legere/PixelFarmingContest/Robot Competition Docs/assembly final/front wheel angel.SLDPRT

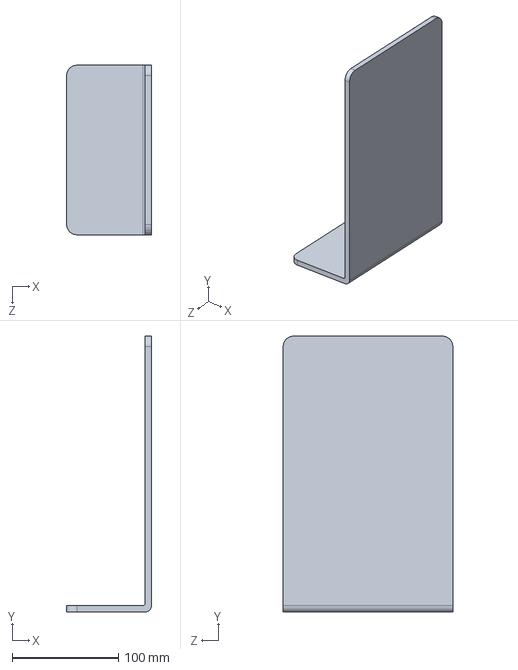
[picture p64: CAD file, 2025-09-10]
Robot Competition Docs/assembly final/front wheel angel.SLDPRT
80.0 x 260.0 x 160.0 mm
