Louis-Legere/PixelFarmingContest/Robot Competition Docs/Handover/OneDrive_1_9.9.2024/All work file/Agrobot_ws-main/Agrobot_ws-main/ros2_ws/src/agrobot_pkg/worlds/obj/Pivot_2Finger_Scaled_Bigger_2.stl

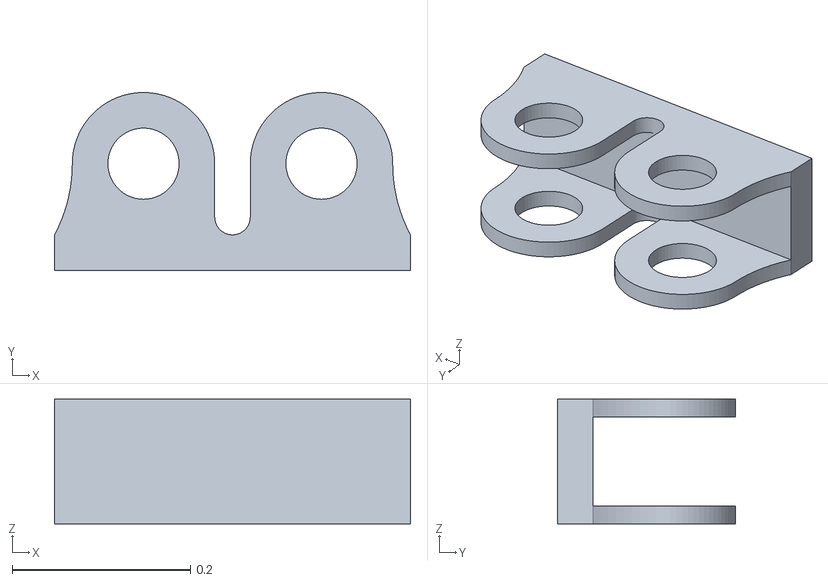
[picture p65: CAD file, 2025-09-10]
Robot Competition Docs/Handover/OneDrive_1_9.9.2024/All work file/Agrobot_ws-main/Agrobot_ws-main/ros2_ws/src/agrobot_pkg/worlds/obj/Pivot_2Finger_Scaled_Bigger_2.stl
0.4 x 0.2 x 0.14
