Louis-Legere/PixelFarmingContest/Robot Competition Docs/assembly final/83d123x0sz8600_06.SLDPRT

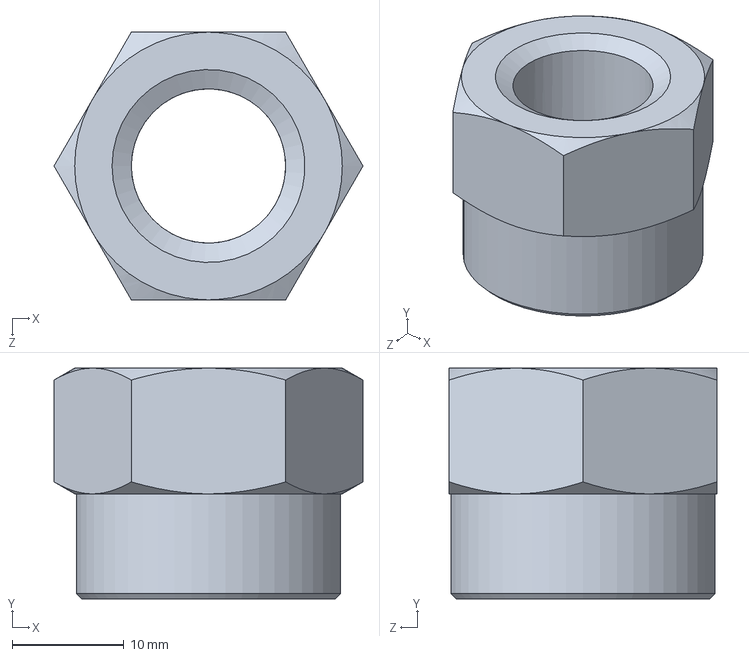
[picture p66: CAD file, 2025-09-10]
Robot Competition Docs/assembly final/83d123x0sz8600_06.SLDPRT
27.7 x 20.7 x 24.0 mm
