Louis-Legere/PixelFarmingContest/Robot Competition Docs/assembly final/83d123x0sz8600_01.SLDPRT

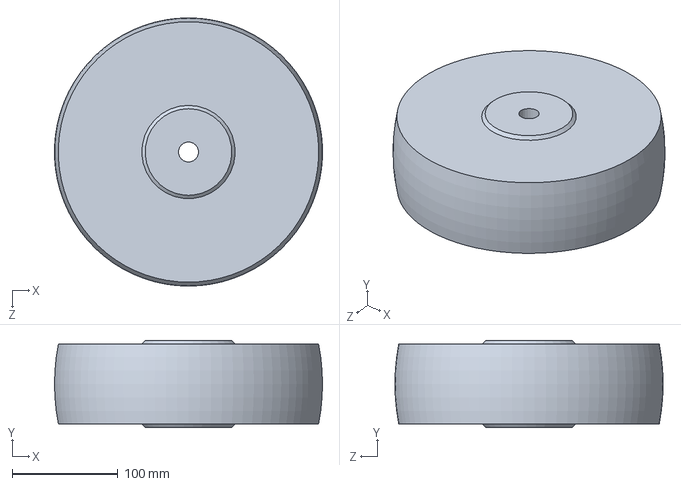
[picture p68: CAD file, 2025-09-10]
Robot Competition Docs/assembly final/83d123x0sz8600_01.SLDPRT
253.8 x 82.6 x 254.0 mm
