Louis-Legere/PixelFarmingContest/Robot Competition Docs/assembly final/83d123x0sz8600_04.SLDPRT

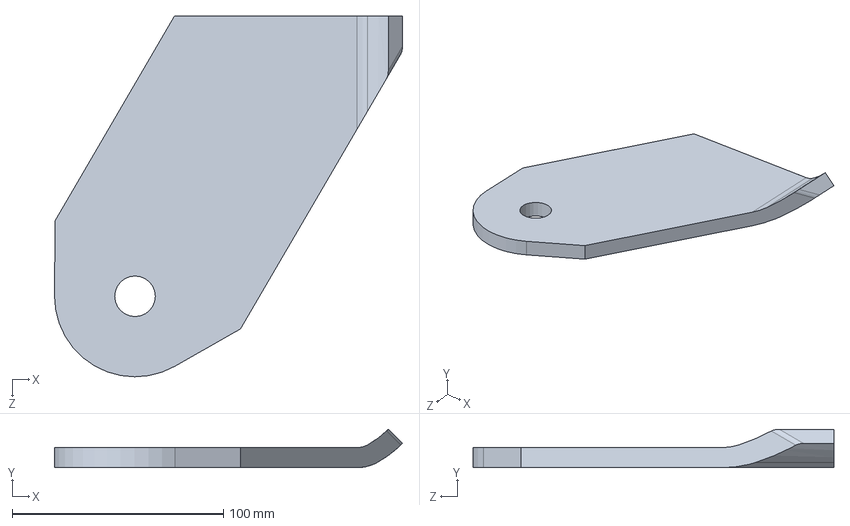
[picture p69: CAD file, 2025-09-10]
Robot Competition Docs/assembly final/83d123x0sz8600_04.SLDPRT
164.6 x 18.2 x 170.6 mm
