Louis-Legere/PixelFarmingContest/Robot Competition Docs/assembly final/83d123x0sz8600_02.SLDPRT

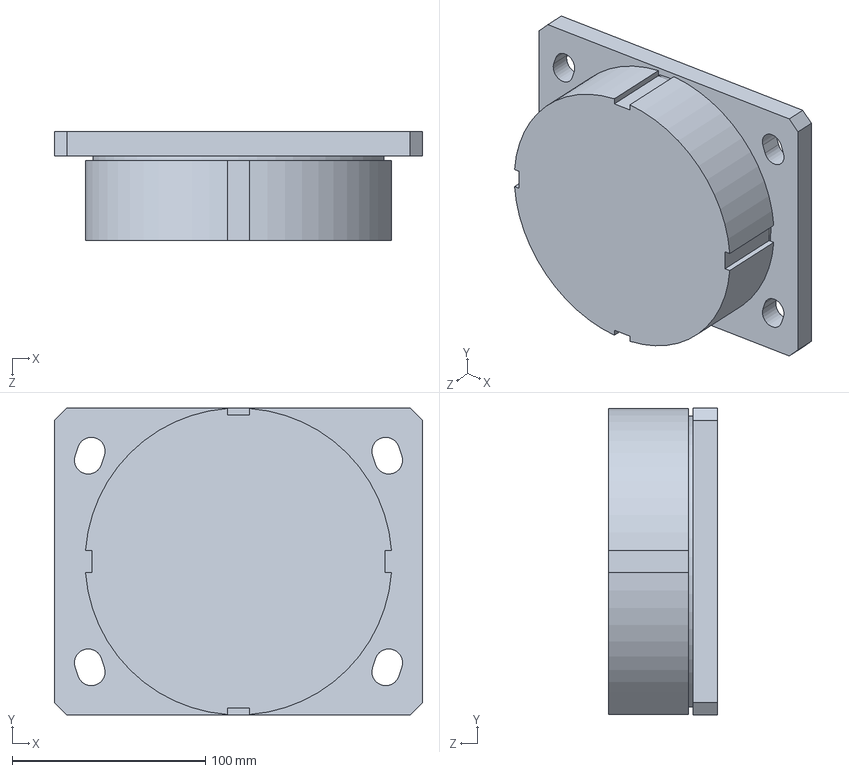
[picture p70: CAD file, 2025-09-10]
Robot Competition Docs/assembly final/83d123x0sz8600_02.SLDPRT
190.5 x 158.8 x 56.5 mm
