Louis-Legere/PixelFarmingContest/Robot Competition Docs/assembly final/83d123x0sz8600_03.SLDPRT

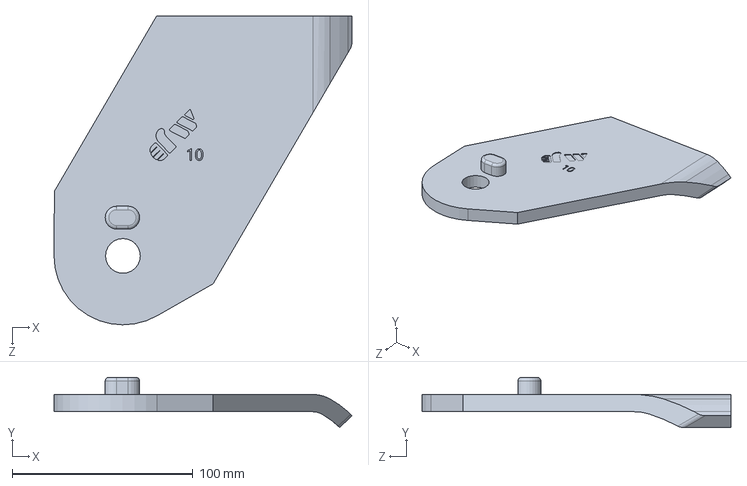
[picture p71: CAD file, 2025-09-10]
Robot Competition Docs/assembly final/83d123x0sz8600_03.SLDPRT
164.7 x 27.8 x 170.6 mm
