Louis-Legere/PixelFarmingContest/Robot Competition Docs/assembly final/83d123x0sz8600_05.SLDPRT

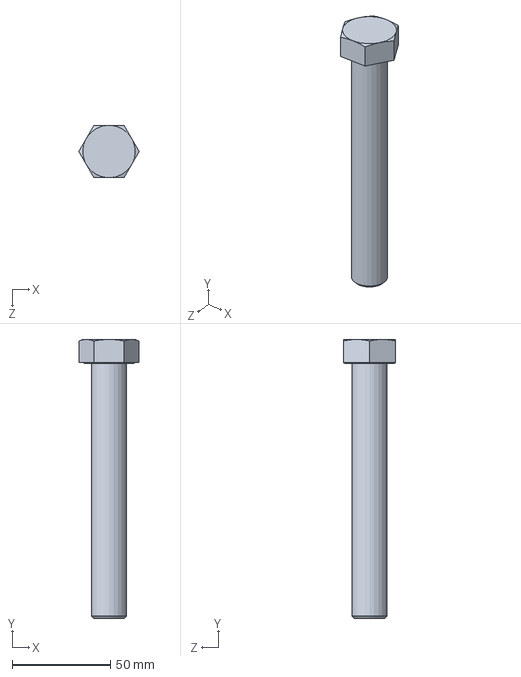
[picture p72: CAD file, 2025-09-10]
Robot Competition Docs/assembly final/83d123x0sz8600_05.SLDPRT
30.8 x 142.2 x 26.7 mm
