Louis-Legere/PixelFarmingContest/(list of files, cad)

Other CAD files:
Robot Competition Docs/assembly final/Assem1.SLDASM
Robot Competition Docs/assembly final/bins/front panle.SLDPRT
Robot Competition Docs/assembly final/backwheel.SLDPRT
Robot Competition Docs/assembly final/bins/bin back.SLDPRT
Robot Competition Docs/assembly final/rear wheel part 1.SLDPRT
Docs/Previous Robot Competition Docs/Assem1/rear wheel part 1.SLDPRT
Docs/Previous Robot Competition Docs/assembly final updated/backwheel.SLDPRT
Docs/Previous Robot Competition Docs/assembly final updated/bin_base.prt
Docs/Previous Robot Competition Docs/assembly final updated/bins v2/bin base v2.SLDPRT
Docs/Previous Robot Competition Docs/assembly final updated/bins v2/frame weldment 1 partr.SLDPRT
Docs/Previous Robot Competition Docs/assembly final updated/bins v2/insert wall.SLDPRT
Docs/Previous Robot Competition Docs/assembly final updated/rear wheel part 1.SLDPRT
Docs/Previous Robot Competition Docs/assembly final/Assem1.SLDASM
Docs/Previous Robot Competition Docs/assembly final/backwheel.SLDPRT
Docs/Previous Robot Competition Docs/assembly final/bin_base.prt
Docs/Previous Robot Competition Docs/assembly final/bins v2/bin base v2.SLDPRT
Docs/Previous Robot Competition Docs/assembly final/bins v2/door v2.SLDPRT
Docs/Previous Robot Competition Docs/assembly final/bins v2/frame weldment 1 partr.SLDPRT
Docs/Previous Robot Competition Docs/assembly final/bins v2/insert wall.SLDPRT
Docs/Previous Robot Competition Docs/assembly final/bins/bin back.SLDPRT
Docs/Previous Robot Competition Docs/assembly final/bins/front panle.SLDPRT
Docs/Previous Robot Competition Docs/assembly final/rear wheel part 1.SLDPRT
Robot Competition Docs/assembly final updated/bins v2/bin base v2.SLDPRT
Robot Competition Docs/assembly final updated/bins v2/insert wall.SLDPRT
Robot Competition Docs/assembly final/bin_base.prt
Robot Competition Docs/assembly final/bins v2/bin base v2.SLDPRT
Robot Competition Docs/assembly final/bins v2/door v2.SLDPRT
Robot Competition Docs/assembly final/bins v2/frame weldment 1 partr.SLDPRT
Robot Competition Docs/assembly final/bins v2/insert wall.SLDPRT
