Louis-Legere/PixelFarmingContest/Docs/manualCommandsAdditionallyToConfig.txt

odrv0.axis0.motor.config.pole_pairs = 10
odrv0.axis0.motor.config.phase_resistance = 0.3575
odrv0.axis0.motor.config.phase_inductance = 0.00101
odrv0.axis0.motor.config.current_lim = 10
odrv0.axis0.encoder.config.cpr = 60
odrv0.axis0.config.startup_closed_loop_control = True
odrv0.save_configuration()
odrv0.reboot()
odrv0.axis0.requested_state = AXIS_STATE_FULL_CALIBRATION_SEQUENCE
odrv0.axis0.encoder.config.pre_calibrated = True
odrv0.axis0.motor.config.pre_calibrated = True
odrv0.save_configuration()
odrv0.reboot()
odrv0.axis0.requested_state = AXIS_STATE_CLOSED_LOOP_CONTROL
odrv0.axis0.controller.input_vel = 1.0
odrv0.axis0.controller.input_vel = 0

odrv0.axis1.motor.config.pole_pairs = 10
odrv0.axis1.motor.config.phase_resistance = 0.3575
odrv0.axis1.motor.config.phase_inductance = 0.00101
odrv0.axis1.motor.config.current_lim = 10
odrv0.axis1.encoder.config.cpr = 60
odrv0.axis1.config.startup_closed_loop_control = True
odrv0.save_configuration()
odrv0.reboot()
odrv0.axis1.requested_state = AXIS_STATE_FULL_CALIBRATION_SEQUENCE
odrv0.axis1.encoder.config.pre_calibrated = True
odrv0.axis1.motor.config.pre_calibrated = True
odrv0.save_configuration()
odrv0.reboot()
odrv0.axis1.requested_state = AXIS_STATE_CLOSED_LOOP_CONTROL
odrv0.axis1.controller.input_vel = 1.0
odrv0.axis1.controller.input_vel = 0
