Louis-Legere/PixelFarmingContest/Robot Competition Docs/Handover/OneDrive_1_9.9.2024/Agrobot_Slider_Assembly_2023-Oct-30_08-58-13AM-000_CustomizedView50921536785.png

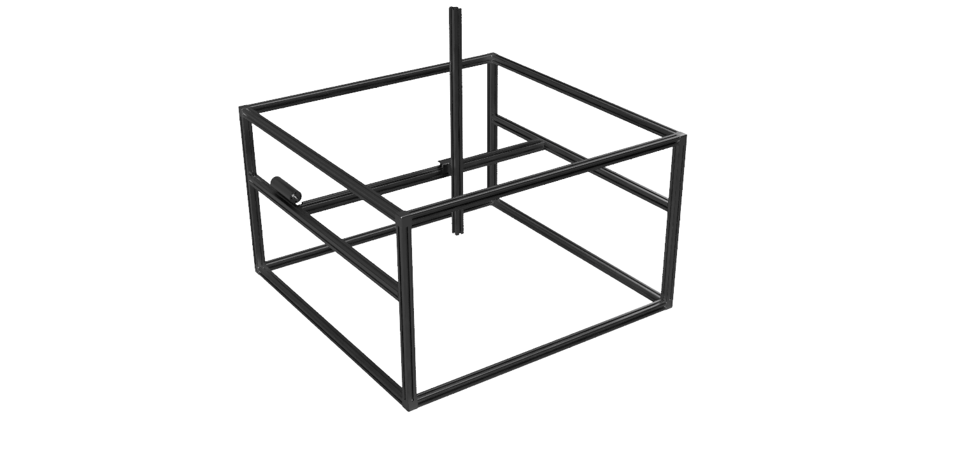
Robot Competition Docs/Handover/OneDrive_1_9.9.2024/Agrobot_Slider_Assembly_2023-Oct-30_08-58-13AM-000_CustomizedView50921536785.png
