Louis-Legere/PixelFarmingContest/Robot Competition Docs/Handover/OneDrive_1_9.9.2024/Agrobot_Slider_Assembly_2023-Oct-30_08-59-20AM-000_CustomizedView29791302639.png

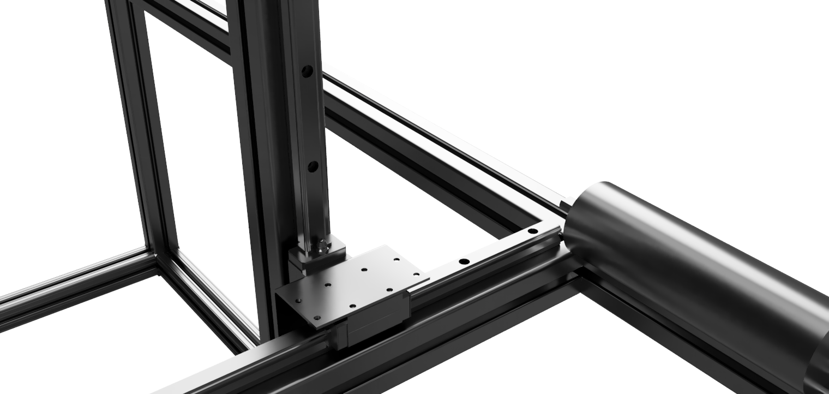
Robot Competition Docs/Handover/OneDrive_1_9.9.2024/Agrobot_Slider_Assembly_2023-Oct-30_08-59-20AM-000_CustomizedView29791302639.png
