Louis-Legere/PixelFarmingContest/Robot Competition Docs/Handover/OneDrive_1_9.9.2024/Research/Feedback research proposal.pdf

# Project agrobot

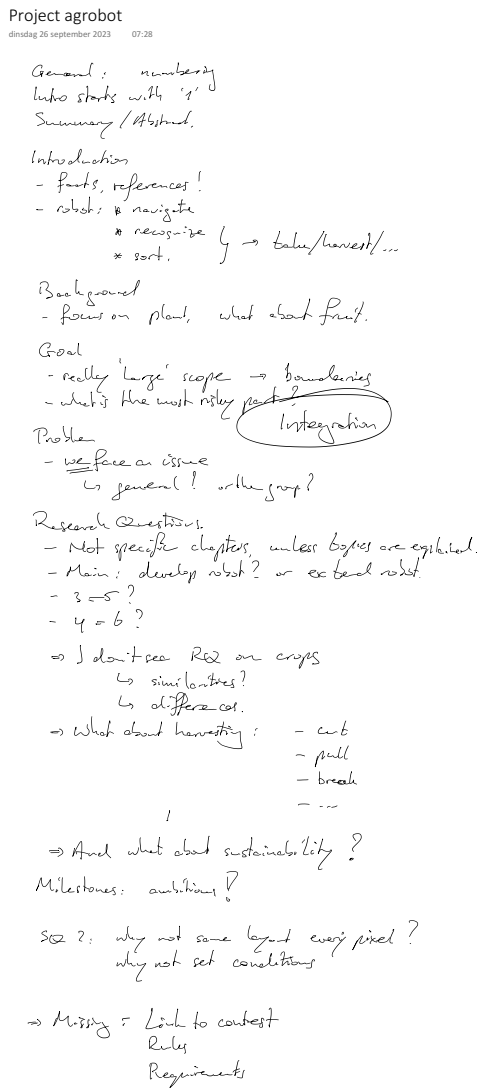
[picture p78: page 1]
dinsdag 26 september 2023
