Louis-Legere/PixelFarmingContest/(commit log)

2025-09-10 more docs
    [83d123x0sz8600.SLDASM, 83d123x0sz8600_01.SLDPRT, 83d123x0sz8600_02.SLDPRT, 83d123x0sz8600_03.SLDPRT, 83d123x0sz8600_04.SLDPRT, 83d123x0sz8600_05.SLDPRT, 83d123x0sz8600_06.SLDPRT, Assem1.SLDASM]
2025-09-10 even more docs
    [83d123x0sz8600.SLDASM, 83d123x0sz8600_01.SLDPRT, 83d123x0sz8600_02.SLDPRT, 83d123x0sz8600_03.SLDPRT, 83d123x0sz8600_04.SLDPRT, 83d123x0sz8600_05.SLDPRT, front wheel angel.SLDPRT, rear wheel part 1.SLDPRT]
2025-09-10 and more docs
    [83d123x0sz8600_06.SLDPRT, Assem1.SLDASM, backwheel.SLDPRT, bin base v2.SLDPRT, bin.SLDASM, bin_base.prt, door v2.SLDPRT, frame weldment 1 partr.SLDPRT]
2025-09-10 guess what, even more docs
    [83d123x0sz8600.SLDASM, 83d123x0sz8600_01.SLDPRT, 83d123x0sz8600_02.SLDPRT, 83d123x0sz8600_03.SLDPRT, 83d123x0sz8600_04.SLDPRT, 83d123x0sz8600_05.SLDPRT, 83d123x0sz8600_06.SLDPRT, front wheel angel.SLDPRT]
2025-09-10 more and more docs
    [Assem1.SLDASM, backwheel.SLDPRT, ball bearing place holder.SLDPRT, bin back.SLDPRT, bin base v2.SLDPRT, bin.SLDASM, bin_base.prt, door v2.SLDPRT]
2025-09-10 holy moly more docs
    [bin base.SLDPRT, door v2 1.sldprt, door.SLDPRT, front panle.SLDPRT, front wheel angel.SLDPRT, rear wheel part 1.SLDPRT, rear wheel part 2.SLDPRT]
2025-09-10 this should work, handover docs
    [Aandrijfvoet 002_2.0 v1.step, Aandrijfvoet 003_2.0 v1.step, Agrobot Frame v15.step, Arm_Scaled_Bigger.stl, Arm_Scaled_Bigger_1.stl, Arm_Scaled_Bigger_2.stl, Base_Scaled_Bigger.stl, Base_Scaled_Bigger_1.stl]
2025-09-24 changed structure
    [83d123x0sz8600.SLDASM, 83d123x0sz8600_01.SLDPRT, 83d123x0sz8600_02.SLDPRT, 83d123x0sz8600_03.SLDPRT, 83d123x0sz8600_04.SLDPRT, 83d123x0sz8600_05.SLDPRT, 83d123x0sz8600_06.SLDPRT, Aandrijfvoet 002_2.0 v1.step]
2025-10-06 added motor datasheet
2025-10-21 both wheel json
2025-10-21 added documentation for motors
2025-10-22 finished motor guide
2025-10-22 changed file structure
    [necessaryStepsAfterRestoringConfig.txt]
2025-11-05 added uart file
2025-11-06 created Usb and Uart folders for seperation
2025-11-06 Revert "created Usb and Uart folders for seperation"
    This reverts commit cffac5c254be55c0893fb59a9a5d3b96e6c41f1b.
    [basicUart.py, movement.py, stop.py]
2025-11-06 changed movement file to uart
2025-11-06 changed bug for turning
    [movement.py]
2025-11-06 changed movement.py so there is a global velocity variable
2025-11-07 imported uartConnection in MovementController
2025-11-10 added prints before state is changed
2025-11-19 added physical test case
2025-11-19 Important commit, have to clean up, so messy, big mess, louis file has been terminated, overall slight improvement, midmaxxing codebased 😎
    ○( ＾皿＾)っ Hehehe…
2025-11-20 arm startup software
